MartinVerges/womolin-waterlevel/housing/Bodenplatte.stl

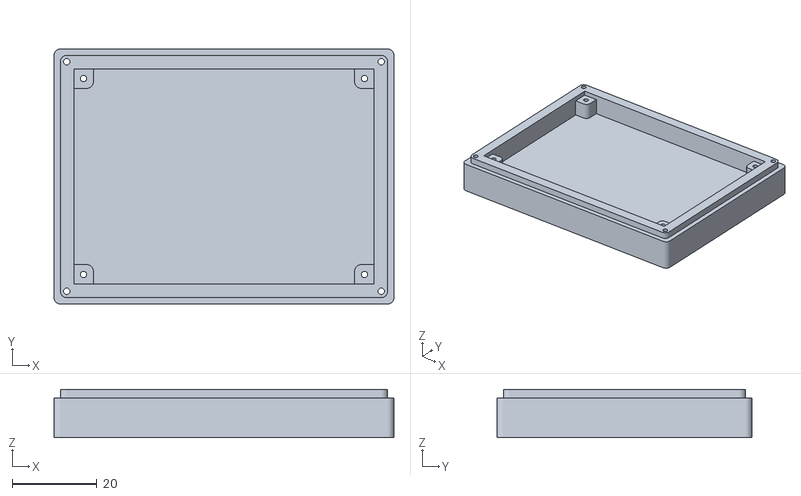
[picture p11: CAD file, 2021-12-18]
housing/Bodenplatte.stl
80.0 x 60.0 x 11.4
