MartinVerges/womolin-waterlevel/housing/Deckel.stl

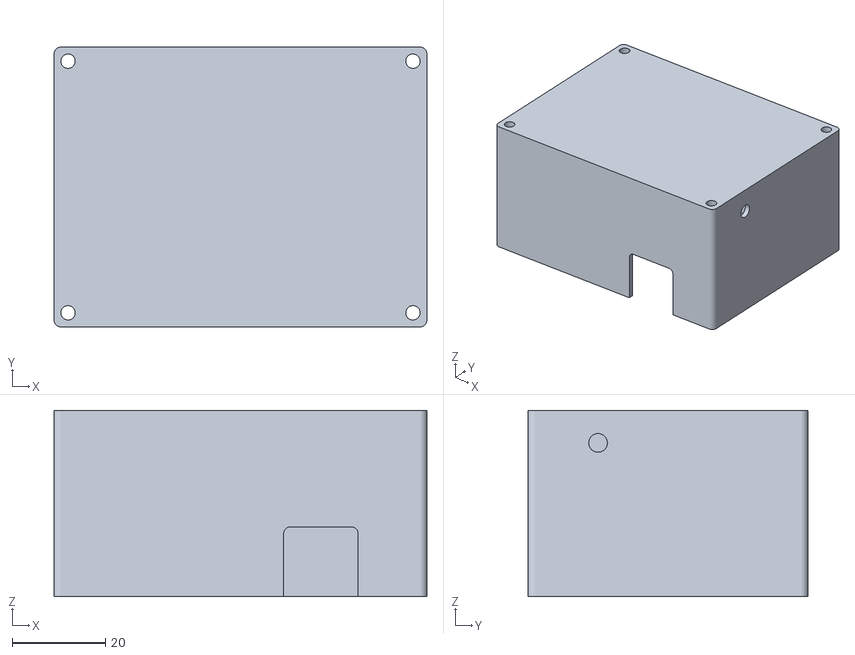
[picture p12: CAD file, 2021-12-18]
housing/Deckel.stl
80.0 x 60.0 x 40.0
