MartinVerges/womolin-waterlevel/(threads)

Thread 1 (2021-12-12):

Saving the settings in the EEPROM does not work yet

MartinVerges, 2021-12-12:
Currently, the configuration of the tank is not stored correctly in the EEPROM. Therefore, the tank must be relearned after each power loss.

MartinVerges, 2021-12-14:
fixed

Closed 2021-12-14.

Thread 2 (2021-12-29):

Thank you for this great simple sensor setup.

red-gee, 2021-12-29:
I like your setup much.
could you also implement Mqtt ?

MartinVerges, 2021-12-29:
Yes, i currently learn BLE and write a android app for it. Mqtt will be next, and easy to implement.

MartinVerges, 2022-01-17:
Sorry the BLE stuff took me way longer than expected. I reworked the UI a bit and can now add MQTT. Do you have any special requirements or needs? Otherwise I would just send the current level to a MQTT broker.

MartinVerges, 2022-01-18:
I just pushed an update including support for mqtt. It's not yet finished and mostly untested, but should already work. Please let me know if you encounter problems with it.

MartinVerges, 2022-01-19:
I pushed another update to it. Now more settings like user/pass are available and it's now working with my test mqtt broker. I would therefore close it as it's fully operational in my believe. Any objections?

Closed 2022-01-29.

Thread 3 (2022-03-06):

Höhenausgleich

Maik2016, 2022-03-06:
Hallo,

ich habe den Sensor ausprobiert, dabei ist mir aufgefallen, das beim Höhenwechsel die Werte sich Ändern, d.h. es würde den Richtigen Füllstand nur Anzeigen auf der Höhe bzw. Luftdruck wo Kalibriert wurde.  Ich konnte es jetzt nur auf geringen Höhenunterschied Beobachten.
Kann das jemand Bestätigen ?  GGF. könnte man mit einem BMP280 das ganze Kompensieren indem man den Vorherrschenden Luftdruck bei der Kalibrierung mit aufnimmt und immer dagegen Abgleicht.

MartinVerges, 2022-03-06:
Hallo,

da es sich um einen Differenzdruck Sensor handelt, sollte dies nicht auftreten, da die Höhe auf beiden Seiten den gleichen Druckunterschied verursacht.

Ich hatte in einem früheren Prototypen einen BMP Sensor und einen Drucksensor im Einsatz, jedoch hat dies zu erheblichen Abweichungen geführt.

Kannst du den Test den du gemacht hast genauer beschreiben?

Ich bin die letzten 4 Tage unterwegs gewesen und habe dabei ca. 400-500 Höhenmeter gehabt. Eine solche Abweichung habe ich jedoch nicht wahrgenommen. Was jedoch in meinem relativ breiten Tank massive Auswirkungen hat, ist die Neigung des Fahrzeugs. Da diese den Druck durch die größer werdenden Wassersäule verändert.

Grüße
Martin

PS: wir können gerne mal einen Video call machen und sprechen.

Maik2016, 2022-03-08:
Hallo,
Ich hatte auch so ca. 200m Höhenunterschied, es könnte auch am Schräg stehen gelegen haben, das muss ich noch mal testen, daher die Idee einen 2 Sensor als Umgebungsdruck Sensor zu verwenden.

Werde dich mal über Telegramm kontaktieren.
Vg.
Maik

MartinVerges, 2022-06-17:
Ich habe aktuell das Modell mit eine kleinen 60 cent Pumpe am laufen. Das funktioniert bei jeder höhe und das Rohr lässt sich neu mit dem Umgebungsdruck befüllen. Soweit wäre das eine Funktionierende Lösung die zu immer gleichen soliden und genauen Messwerten führt. Ganz happy bin ich damit leider nicht, weil ich eigentlich auf den Komplexitätsgrad verzichten würde!

Closed 2022-12-22.

Thread 4 (2023-06-13):

Füllstand einer Zisterne messen

deHarro, 2023-06-13:
Hallo Martin,
tolles Projekt und eine gute Idee!
Dies ist eigentlich kein Issue, eher eine Diskussion... eine Discussions Ecke kannst du über Github einrichten :)

Mein Ansinnen ist, den Füllstand einer Zisterne mit 4 m³ zu erfassen.
Die Zisterne ist im Garten eingegraben, Abstand zum Haus ca. 4 m.

Die direkte Messung wie in deinem Video gezeigt, wird auf Dauer nicht funktionieren, denke ich, da es (mir) unmöglich scheint, das Ganze System so abzudichten, dass auch über lange Zeit (Jahre) keine Luft aus dem Messsystem entweicht (oder im Wasser gelöst wird oder sonstwie abhanden kommt).

Dein zweiter Ansatz, die Luft erst zum Zeitpunkt der Messung per Pumpe ins System zu bringen, erscheint mir für diesen Einsatzfall jedoch super geeignet.
Meine Physikkenntnisse sind schon etwas eingerostet, aber ich denke, die Idee ist, dass der von der Pumpe erzeugte Druck im Schlauch dem außen (außerhalb des Sondenrohres ) anstehenden Wasserdruck entspricht, sobald die eingepumpte Luft unten aus dem Messrohr heraus blubbert und sich der Druck im Schlauch nicht mehr weiter erhöht.
Bin ich da auf dem Holzweg, oder stimmt meine Annahme?
Danke!

Harald

MartinVerges, 2023-06-13:
Hallo,

Ja, durch die kleine Luftpumpe wird das Problem mit etwaigen Undichtigkeiten behoben. Man bläst ein wenig Luft in das Messrohr bis es heraus blubbert. Sobald die Pumpe abgestellt wird, drückt das Wasser über die Luft im Rohr auf den Sensor der damit eine korrekte Messung durchführen kann.

Mit dem Repo und den Beispielaufbau kannst Du direkt Deine Zisterne messen. Das muss fehlerfrei klappen.

Grüße
Martin

deHarro, 2023-06-13:
Hi Martin,

für den gedachten Einsatzfall (und vor allem für die bei mir in der Schublade liegenden Teile aus einem anderen Projekt) ist dein Repo eher ungeeignet.

"..wenig Luft in das Messrohr..." ... Gilt das auch für eine ca. 3 m tiefe (bzw. den Wasserstand in dieser Höhe in der) Zisterne?
Da muss ich doch ggf. ziemlich Druck aufbauen, nach Adam Riese eben 3 bar. Und den Schlauch füllen...

Aber die Bestätigung meiner Annahme reicht mir schon erst mal, vielen Dank!
Dass die Bauelemente dann zum Einsatzfall passen, muss ich selbst sicher stellen.

Gruß, Harald

MartinVerges, 2023-06-13:
Es müssten 0,3 bar sein, oder nicht?

deHarro, 2023-06-14:
Natürlich 🥴. Ist mir heute Nacht auch noch durch die Birne geblitzt, da lag ich aber schon lange im Bett...

Dumm gelaufen, zumal ich eine halbe Stunde vorher Einheitenumrechnung geübt habe, um abzuschätzen, ob mein vorhandener Sensor für den zu erwartenden Druckbereich geeignet ist. Da musste ich kPa in mm Wassersäule für die Zisterne und in bar für den Kopf umrechnen.
Mein Sensor ist ein MPX5050G, der misst bis 50 kPa, also 5 m Wassersäule und natürlich 0,5 bar 😊, passt also wunderbar.
Die vorhandene Pumpe dürfte etwas zu grob sein, damit wollte ich die in meinem Autositz integrierten Luftpolster der Lordosestütze mit passendem Druck beaufschlagen. Das Projekt ist aber eingeschlafen, da ich zwischenzeitlich das Auto gewechselt habe 😃.
Ich kann dich gerne auf dem Laufenden halten, wenn es dich interessiert.
Oder du schaust [hier](http://harald-sattler.de/) nach, ob und wann es was geworden ist... Unter "Aktuell" erscheint dann irgendwann ein Link auf das Projekt.

Gruß, Harald

poweroxadmin, 2023-07-05:
Hallo Zusammen,

@Martin - erst einmal krass Respekt für das Projekt und Deine Vorarbeit, ich ziehe meinen Hut!
bei mir soll das ganze auch in zwei Zisternen eingebaut werden, und dann eben den Wasserstand messen.
Ich sehe das mit der Dichtigkeit und der feuchten Umgebung bei mir eher unkritisch.
Mein Aufbau würde vorsehen dass das Case mit Pumpe/Sensor/ESP/... entweder in einer Verteilung oder einem wasserdichten Case in einer Schlauchbox sitzt. Der Schlauch selbst sollte dann nicht länger als 10m werden.
Wenn es gut läuft, baue ich das noch vor dem Urlaub nach - mal schauen wie ich es schaffe.

Die beiden Fragen die ich mir gestellt habe waren in dem Zusammenhang nur ...
A - die Zistenern sind beide "liegende Zylinder" - da müsste ich mir dann für die Integration in Home Assistant eine Formel ausdenken mit der ich das Näherungsweise in Volumen umrechnen kann für ein Dashboard ...
oder habt Ihr da schon eine Lösungs-Idee?
B - zum Eichen des Systems - mein Ansatz wäre es die Zisterne maximal zu füllen, und dann das PVC-Rohr mit dem fixierten Schlauch drin, langsam in die Zisterne einführen und am Dom der Zisterne fixieren.
Das müsste doch technisch analog dem Befüllen des Tanks näherungsweise folgen.

Danke für Euer Feedback.

Gruß - Ralf

deHarro, 2023-07-05:
Hallo Ralf,

die Geschichte mit dem Eichen ist m.E. bei einer Tankform wie bei uns (liegender bzw. bei mir stehender Zylinder) unnötig.
Mit ein bisschen Physik kannst du vom Druck im Tauchrohr mehr oder weniger direkt den Füllstand in m, cm oder mm ableiten und mit den Formeln zum Inhalt von Zylindern daraus direkt den Inhalt in Litern oder mir auch in m³ ableiten.

Ich bin, angefixt von Martins Idee, auch gerade dran, unsere Zisterne messtechnisch zu erfassen. Das Programm steht soweit, momentan konstruiere ich den Meßaufnehmer (einen dünnen Schlauch, der in einem vorhandenen Leerrohr in die Zisterne geschoben werden wird und einem dünnen Rohr, das dann senkrecht in der Zisterne irgednwo fest gemacht wird.

Einen Einziehdraht (aus Kunststoff) habe ich an den vorhandenen drei Leitungen für die elektronische Füllstandsüberwachung vorbei schon in das Leerrohr eingeschoben, jetzt hadere ich mit den Möglichkeiten, einen glitschigen Kunststoffdraht mit dem PTFE-Röhrchen so zu verbinden, dass ich das Röhrchen ohne Abriss in das Leerrohr gezogen bekomme.

Die Elektronik (ein Digistump) wird im Haus platziert (die Zisterne ist ca. 4-5 m von Haus entfernt eingegraben), ich erwarte also keine Probleme im Zusammenhang mit Feuchte oder Getier.

Gruß, Harald

poweroxadmin, 2023-07-05:
Hallo Harald,

das ging ja schnell mit der Rückmeldung ... danke.
ja - ich bin da auch eher optimistisch, und hoffe dass das auf anhieb funktioniert.

zu Deinen Herausforderungen beim Einziehen des Schlauchs ...
erst einmal habe ich die Erfahrung gemacht braucht es viel VIEL Rohrgleitmittel :-)
und dann würde ich in den Schlauch was härteres einführen, und dann mit einem Draht den weichen schlauch darauf fixieren - aber ich denke da führen viele Wege zum Ziel.

Viel Erfolg jedenfalls!!!

Gruß |> Ralf

MartinVerges, 2023-07-05:
Hallo,

In der Software gibt es die Möglichkeit das Volumen anzugeben und so die verbleibenden Liter zu erhalten.

Wenn ihr Änderungen habt, ich bin da offen und hoffe das mehr Leute das nachbauen und nutzen.

Grüße

poweroxadmin, 2023-07-05:
Hallo Martin,
danke für die Bereitschaft zum Austausch ...
da ich hier dann meinen ersten "Sensor" und auch meinen ersten ESP verbaue,
wäre ich Dir dankbar wenn Du mir noch ein wenig mehr Einblick mit ein paar Bildern geben könntest,
wie Du das auf den Platten angeordnet bzw. fixiert hast.
ich denke ich bekomme das sicher irgendwie hin, aber bevor ich irgendwas kaputt mache bzw.
abbreche bin ich natürlich für alle Hinweise dankbar.
die Reihenfolge ist ja sicher erst einmal alles auf den Platten zusammenbauen, verdrahten & verlöten und dann die Software-Komponenten drauf bringen - oder?
Gruß |> Ralf

deHarro, 2023-07-05:
Hallo Martin, Ralf,

ich bin dabei, meine Umsetzung des Füllstandmessers auf meiner Homepage zu veröffentlichen.
Ist noch im Wachsen, aber ihr könnt gerne schon mal einen Blick auf die Seite werfen: [Füllstandmesser](http://harald-sattler.de/html/fullstandmesser.htm)
In den nächsten Tagen kommt noch die Verbindung zwischen Schlauch und Messrohr dazu und natürlich die Realisierung in der Zisterne.

Harald

@Ralf
Hast du eine Empfehlung für das Gleitmittel?
Ich habe in der Vergangenheit schon gelesen, dass Nivea für sowas verwendet wurde.
Die Einziehhilfe habe ich lieblos mit Maschinenfett eingesaut und nach gefühlt 2 Stunden effektiver Arbeit, mit Pausen, in denen ich mir die rote Hassmütze ganz tief ins Gesicht gezogen habe, weil das so überhaupt nicht funktionieren wollte, hat das Ende in der Zisterne gebaumelt.
Wenn ich beim Einziehen des Schlauchs auf halbem Weg die Verbindung abreiße, weiß ich nicht, ob ich einen zweiten Versuch unternehme...

deHarro, 2023-07-05:
Hallo Martin,

> Wenn ihr Änderungen habt, ich bin da offen und hoffe das mehr Leute das nachbauen und nutzen.

Wie oben schon geschrieben, ist mir deine umfängliche Lösung eine Nummer zu groß für meine Zisterne. Da ich keine kontinuierliche Erfassung benötige und keine Einbindung in eine Hausautomatisierung benötige, habe ich eigentlich keine Änderungswünsche für deine Implementierung. Der Einsatzfall Zisterne ist doch zu unterschiedlich zur Behälterüberwachung im WoMo.
Bei mir ist es eigentlich nur Neugier, die Nachspeisung mit Frischwasser erfolgt automatisch, wenn der Pegel zu weit absinkt.
Das Regenwasser wird bei uns übrigens für die Toilettenspülung verwendet, daher auch die Nachspeisung 😉.

Harald

poweroxadmin, 2023-07-06:
Mahlzeit ...
@Harald - nimm einfach das Gleitmittel aus dem Baumarkt dass benutzt wird um KG-Rohre miteinander zu verbinden.
Kleiner Tip bei Einziehhilfen - hier sind die am besten die "gedreht" sind - da verringert sich die Oberfläche und damit die Reibung - die sind um ein vielfaches besser, aber auch leider teurer. [Beispiel](https://www.amazon.de/Einziehband%EF%BC%8CEinziehdraht-4mm%EF%BC%8CEinziehhilfe%EF%BC%8CKabeleinziehhilfe%EF%BC%8CEinziehband-8m%EF%BC%8CEinziehspirale%EF%BC%8CWiro-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)
@MartinVerges
tut mir leid dass ich hier wahrscheinlich noch eine Lernkurve habe ... aber es ist leider mein erstes Projekt mit selbstgebautem Sensor.
in Deinem Schema sehe ich noch einen Transistor/Widerstand/Diode ... und den BMP180 - mal abgesehen dass es einen NodeMCU-32s zeigt, die Einkaufsliste referenziert den [ESP32-WROOM-32](https://womolin.de/produkt/wemos-d1-mini-esp32/). Hast Du das zwischenzeitlich im Projekt geändert, bzw. ist das Bild nicht ganz aktuell?

Vielen Dank für ein kurzes Feedback
Gruß - Ralf

deHarro, 2023-07-06:
Hi Ralf!
> Kleiner Tip bei Einziehhilfen - hier sind die am besten die "gedreht" sind - da verringert sich die Oberfläche und damit die Reibung - die sind um ein vielfaches besser, aber auch leider teurer. [Beispiel](https://www.amazon.de/Einziehband%EF%BC%8CEinziehdraht-4mm%EF%BC%8CEinziehhilfe%EF%BC%8CKabeleinziehhilfe%EF%BC%8CEinziehband-8m%EF%BC%8CEinziehspirale%EF%BC%8CWiro-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)

Hihi, gilt das auch für Plastikrohre mit 30 mm Innendurchmesser in dem schon drei ca. 7 mm dicke Gummikabel eingezogen sind?
Meine Kunststoff-Einziehhilfe hat 3 mm Durchmesser und ging gerade so durch.
Das von dir verlinkte Kabel hat eine 9 mm breite Öse angeschlagen. Weiß nicht, ob dafür überhaupt noch Platz in der Röhre ist.

Aber das Gleitzeugs habe ich mal bestellt... bin gespannt, Danke für die Tipps!

Harald

deHarro, 2023-07-15:
Update...

Der Tipp mit dem Gleitmittel war Gold wert, danke nochmal Ralf!!

Ich habe natürlich zuerst mal versucht, den Schlauch - mit etwas Gleitmittel - parallel zur Einziehhilfe und den drei Leitungen zusätzlich in das Rohr zu stopfen. Naja, hat dreimal nicht geklappt, dann hatte ich erst mal die Nase voll und habe mich schmollend anderen Dingen zugewandt.

Das Zusammenfuddeln des Schlauchs mit der Einziehhilfe zum Durchziehen hatte ich allerdings immer noch nicht gelöst, nicht mal ansatzweise.

Deshalb habe ich nach ein paar Tagen einen weiteren Versuch gewagt, wieder von innen im Keller und schiebend. Das hat den Charme, dass ich hier stehen kann und den Schlauch auf Augenhöhe bedienen kann, nicht wie an der Zisterne auf dem Bauch im Gras liegend.

Diesmal tat ich so richtig Gleitmittel auf den Schlauch und gleich von Anfang an, nicht erst nach dem ersten Meter und dann nur alle paar zehn Zentimeter. Und ich habe eine andere Stelle zwischen den drei Leitungen gewählt. Ach ja, und ich habe die kleine Schraube aus dem vorderen Ende entfernt, die ich dort reingedreht hatte, damit unterwegs kein Dreck in das Röhrchen kommt. Die Schraube stand nur ca. einen halben Millimeter über, aber immerhin.

Was genau jetzt der springende Punkt war, kann ich natürlich nicht sagen, aber auf jeden Fall hatte ich plötzlich ohne größere Probleme mit stecken bleiben oder abknicken nur noch ca. 3-4 m von dem Schlauch auf dem Boden liegen und dachte, jetzt schau ich mal draußen nach, ob der Schlauch schon rausschaut. Bingo! Dem war so 😊.

Bilder und so weiter stelle ich auf der HP zusammen ([Link](http://harald-sattler.de/html/fullstandmesser.htm)).

Harald

Thread 5 (2023-06-27):

Support for AJ-SR04M Sensor

s3m1s0n1c, 2023-06-27:
Hello,

Thanks for this awesome project.

Is there any way to support the AJ-SR04M Distance sensor instead ADC and MPX53DP?

Thanks
Sonic

MartinVerges, 2023-06-27:
Technically there is nothing that would prevent this. But I can't add it
without test equipment, so please feel free to add it to the code base and
I happily merge it.

However, please carefully check the manual. A quick search shows a range of
20cm – 450cm. For a tank level, this could be a show stopper.

Grüße

Sonic ***@***.***> schrieb am Di., 27. Juni 2023, 09:35:

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

s3m1s0n1c, 2023-06-27:
Well I would just need the gui changed so you can input the GPIO pins for Trigger and Echo..

What kind of sensors should I be using if this one is no good?

Thanks
Sonic

MartinVerges, 2023-07-05:
Why don't you try the one from my build?

Thread 7 (2023-08-25):

Air pressure measuring issues

OldPlanets, 2023-08-25:
Thanks for this great project. This was exactly what I was looking for, and it's great that someone else already did such a great job building and implementing it. 👍

Now about my issue: I'm not sure if it matters, as I'm not proficient enough in relevant physics, but I have chosen a different design for my measurement tube. Basically, I'm just using 4mm Quick Connectors with a check valve behind the pump, a Y-Connector to join the sensor and air pump tube, and then a bulkhead connector for the tank. So just one single, small tube is going into the tank. For me, this has the advantage of being easier to make; it looks cleaner, and I can leave the last part of the tube in the tank forever and just connect the tube from the device to the bulkhead connector.

I have tested it, and it is airtight and all, keeping the pressure over days. However, I have run into one issue: Using the pump produces a significantly higher pressure reading (about 10-15% in my local tests) inside the test tube than if I fill the empty jar (test tank) with water but don't use the pump. I'm sure there is an exact physical explanation for it, but I don't know it.

Does anyone know if that's because of my changed measurement tube, or does the suggested setup have similar issues? Does using a larger/wider tube mitigate it?

For now, I'm planning to just detect if the tank gets filled up (which only happens every few days anyway) and run the pump on those occasions, as well as running the pump between the setup steps when the water fills up, and reference values are taken.

On a side note: Right now, the build compensates changes in atmospheric pressure by running the pump. Wouldn't it theoretically be possible to compensate for the changes by calculation? So you could have builds without a pump, as long as your tank gets totally emptied every few days/weeks to make up for diffused air

MartinVerges, 2023-08-25:
Hello,

It already tries to compensate the ambient change a bit, but I'm not that
good in developing a solid math to do so reliable enough.

My first approach to solve the issue of going uphill and downhill was a
pump, but I couldn't find a air tight cheap small pump for this. Please
share the exact parts you are using, that's awesome.

Regarding the higher reading: Yes you have to wait a short time (2 sec or
so) until the pressure is on a correct level again. Besides that, nothing
that I noted so far using the pump.

Best regards
Martin Verges

OldPlanets ***@***.***> schrieb am Fr., 25. Aug. 2023, 06:45:

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

OldPlanets, 2023-08-25:
Parts for the tube I use? They are pretty standarized but I got mine here:
https://www.wassertechnik.pro/steckverbinder/metrisch/
On the attached picture you can see the three items I used (+ the tubes).

As for the pressure, no it's not just a few seconds, it stays constant for hours. And I'm sure it is actually higher pressure (so a physical thing) not a sensor issue. I'm just not sure what's causing it and if it's actually the proper measurement (and pouring water in without the air pump has some skew) or if something in my setup causes it. I suppose I should be able to calculate it, after all I know how much pressure a given water column should result in, but I haven't tried that yet.
But again, adjusting the code for it is not a problem, I'll probably go that way.

(I'm also doing some other changes because my build doesn't have a Wifi button, so I'll use power up to turn on Wifi for X minutes. And I'm also hoping to use the light sleep with BLE, whcih I read should be fine, but not there yet.)

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
