MartinVerges/womolin-waterlevel/PCB/Caravansensor.kicad_pcb

## KiCad design PCB/Caravansensor.kicad_pcb (2022-04-24)

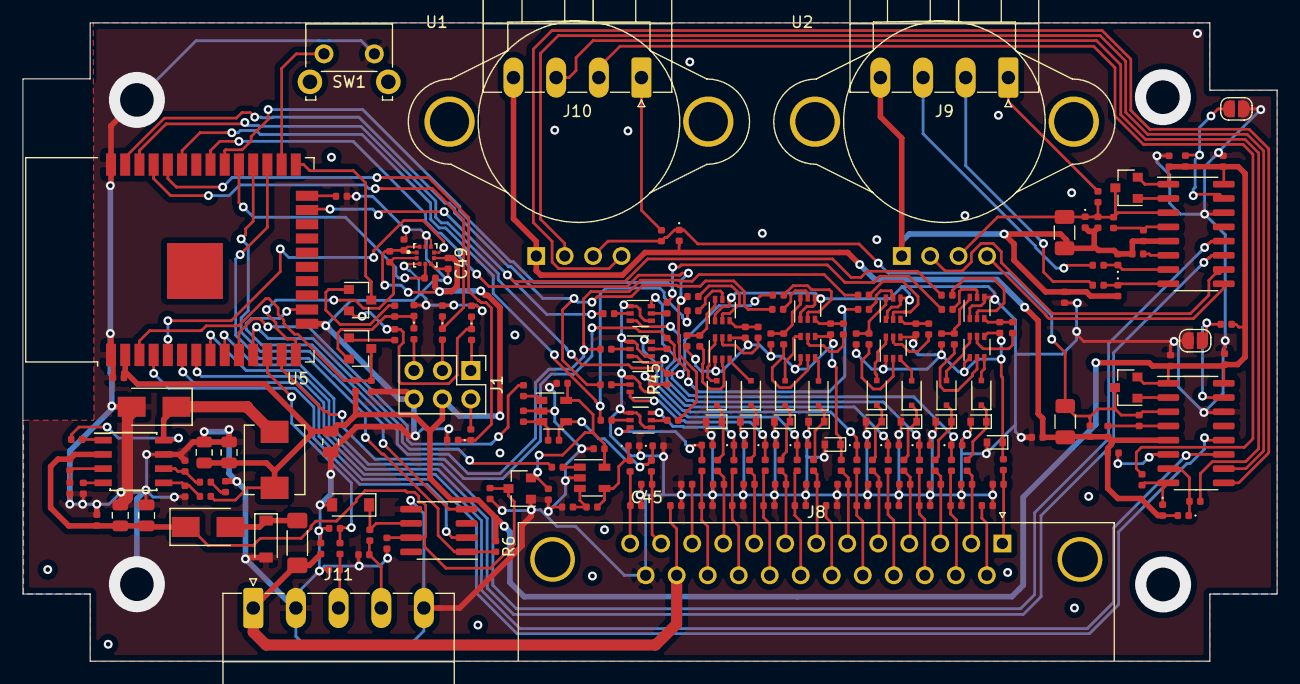
[picture p13: board Caravansensor.kicad_pcb from above]

Board: 2 copper layers, 112.0 x 57.0 mm, 226 parts (0 on the bottom side), 164 nets.

Parts:
C1, C2, C5, C6, C7, C8, C9, C10, C11, C12, C13, C14, C20, C21, C40, C41, C42, C43, C44, C47, C48, C49, C53: 100n; C_0402_1005Metric
C3, C4: 10u; C_1206_3216Metric
C15, C52: 100p; C_0402_1005Metric
C16, C17: 4u7; C_0805_2012Metric
C18, C51: 1n; C_0402_1005Metric
C19: 47p; C_0402_1005Metric
C22, C23, C50: 47u; C_0805_2012Metric
C24, C25, C26, C27, C28, C29, C30, C31, C32, C33, C34, C35, C36, C37, C38, C39, C45, C46: 10n; C_0402_1005Metric
D1, D3: SMF16A; D_SOD-123
D2, D4: B340A; D_SMA
D5, D6, D7, D8, D17, D18, D19, D20, D31, D32, D33, D34, D35, D36, D37, D38, D39, D40, D41, D42, D43: RCLAMP0521P-N; D_0402_1005Metric
D9, D10, D11, D12, D21, D22, D23, D24: 1N4148WS; D_SOD-323F
D13, D14, D15, D16, D25, D26, D27, D28, D29, D30: ESD5Z15V; D_SOD-523
F1: Polyfuse; Fuse_1806_4516Metric
J1: Conn_02x03_Odd_Even; PinHeader_2x03_P2.54mm_Vertical
J8: DB25_Female; DSUB-25_Female_Horizontal_P2.77x2.84mm_EdgePinOffset7.70mm_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
J9, J10: Conn_01x04; PhoenixContact_MC_1,5_4-G-3.81_1x04_P3.81mm_Horizontal
J11: Conn_01x05; PhoenixContact_MC_1,5_5-G-3.81_1x05_P3.81mm_Horizontal
JP2, JP3: Jumper_2_Open; SolderJumper-2_P1.3mm_Open_RoundedPad1.0x1.5mm
L1: SLO0630H6R8MTT; L_Neosid_SM-PIC0512H
L2, L3: L; L_0402_1005Metric
Q1, Q2: MMBTA92-Transistor_BJT; SOT-23
Q3, Q4: MMBT5401; SOT-23
Q5, Q6, Q7, Q8, Q11, Q12, Q13, Q14: LBSS260DW; SOT-363_SC-70-6
Q9, Q10, Q15, Q16: LBSS84DW; SOT-363_SC-70-6
R1, R3: 20k; R_0402_1005Metric
R2, R4: 8k2; R_0402_1005Metric
R5, R6, R8, R9, R19, R20, R21, R22, R23, R24, R25, R26, R27, R28, R29, R30, R31, R32, R33, R34, R43, R44, R45, R46, R47, R48, R49, R50, R51, R52, R53, R54, R55, R56, R57, R58, R90, R91: 10k; R_0402_1005Metric
R7, R13, R14, R15, R16, R71, R72, R77, R78, R79, R80, R81, R82, R83, R84, R85, R89: 100r; R_0402_1005Metric
R10: 332k; R_0402_1005Metric
R11: 68k1; R_0402_1005Metric
R12: 29k4; R_0402_1005Metric
R17: 10k2; R_0402_1005Metric
R18: 3k24; R_0402_1005Metric
R35, R36, R37, R38, R39, R40, R41, R42, R59, R60, R61, R62, R63, R64, R65, R66, R67, R69, R75, R76: 1k; R_0402_1005Metric
R68, R70: 200k; R_0402_1005Metric
R73, R74: 100k; R_0402_1005Metric
R86, R87: 4k7; R_0402_1005Metric
R88: 12k; R_0402_1005Metric
SW1: TS-1093A-A12B3-D2; SW_Tactile_SKHH_Angled
U1, U2: MPX53; 344C
U3, U4: HX711; SOIC-16_3.9x9.9mm_P1.27mm
U5: ESP32-WROOM-32D; ESP32-WROOM-32
U6: TJA1021T; SOIC-8_3.9x4.9mm_P1.27mm
U7: TPS54331D; SOIC-8_3.9x4.9mm_P1.27mm
U8, U9: LMV321; SOT-23-5
U10: BMP388; PQFN50P200X200X80-10N
U11: ME6209A50M3G; SOT-23

Connections:
1_Wire: D39.1, R89.2, U5.12
+3V3: C7.1, C8.1, C9.1, C10.1, C12.1, C22.1, C23.1, C49.1, C50.1, C53.1, J1.4, L1.2, Q1.2, Q2.2, R6.1, R17.1, R86.1, R87.1, R88.1, R90.2, R91.2, U3.1, U3.16, U4.1, U4.16, U5.2, U10.1, U10.6, U10.10
+5V: C40.2, C41.2, C48.1, U8.5, U9.5, U11.2
+BATT: C13.1, C14.1, C16.1, C17.1, C47.1, D2.1, R10.1, U6.7, U7.2, U11.3
BME_INT: U5.5, U10.7
FW_25: R22.2, R26.2, U5.30
FW_25_out_neg: C27.1, J8.15, R38.2
FW_25_out_pos: C31.1, J8.2, R42.2
FW_50: R21.2, R25.2, U5.23
FW_50_out_neg: C26.1, J8.16, R37.2
FW_50_out_pos: C30.1, J8.3, R41.2
FW_75: R20.2, R24.2, U5.13
FW_75_out_neg: C25.1, J8.17, R36.2
FW_75_out_pos: C29.1, J8.4, R40.2
FW_100: R19.2, R23.2, U5.16
FW_100_out_neg: C24.1, J8.18, R35.2
FW_100_out_pos: C28.1, J8.5, R39.2
FW_Analog_ESP: R67.2, U5.10
FW_Analog_out: C45.1, J8.12, R75.1
GND: C7.2, C8.2, C9.2, C10.2, C11.2, C12.2, C13.2, C14.2, C15.2, C16.2, C17.2, C19.2, C20.2, C22.2, C23.2, C24.2, C25.2, C26.2, C27.2, C28.2, C29.2, C30.2, C31.2, C32.2, C33.2, C34.2, C35.2, C36.2, C37.2, C38.2, C39.2, C40.1, C41.1, C42.2, C43.2, C44.2, C45.2, C46.2, C47.2, C48.2, C49.2, C50.2, C51.2, C52.2, C53.2, D1.2, D3.2, D4.2, D5.2, D6.2, D7.2, D8.2, D13.2, D14.2, D15.2, D16.2, D17.2, D18.2, D19.2, D20.2, D25.2, D26.2, D27.2, D28.2, D29.2, D30.2, D31.2, D32.2, D39.2, D40.2, D41.2, D42.2, D43.2, J1.6, J8.25, J11.2, J11.5, JP2.2, JP3.2, L2.2, L3.2, Q5.1, Q5.4, Q6.1, Q6.4, Q7.1, Q7.4, Q8.1, Q8.4, Q11.1, Q11.4, Q12.1, Q12.4, Q13.1, Q13.4, Q14.1, Q14.4, R5.2, R11.2, R12.2, R18.2, R68.2, R70.2, R77.2, R78.2, R79.2, SW1.2, U3.14, U4.14, U5.1, U5.15, U5.38, U6.5, U7.7, U8.2, U9.2, U10.3, U10.5, U10.8, U10.9, U11.1
GPIO_0: Q3.3, U5.25
INA_N_1: D38.1, R85.1, U4.7
INA_N_2: D37.1, R82.1, U3.7
INA_P_1: D36.1, R84.1, U4.8
INA_P_2: D35.1, R81.1, U3.8
LIN: C15.1, J11.4, R7.1
LIN_RX: R6.2, U5.27, U6.1
LIN_SLP: U5.4, U6.2
LIN_TX: U5.28, U6.4
unnamed: C1.1, C3.1, D33.1, Q1.3, R1.1, R80.1, U1.3, U3.3
unnamed: C1.2, C3.2, C5.2, D33.2, D35.2, D37.2, J10.4, L2.1, R2.2, U1.1, U3.5
unnamed: C2.1, C4.1, D34.1, Q2.3, R3.1, R83.1, U2.3, U4.3
unnamed: C2.2, C4.2, C6.2, D34.2, D36.2, D38.2, J9.4, L3.1, R4.2, U2.1, U4.5
unnamed: C5.1, U3.6
unnamed: C6.1, U4.6
unnamed: C18.1, C19.1, U7.6
unnamed: C18.2, R12.1
unnamed: C20.1, U7.4
unnamed: C21.1, U7.1
unnamed: C21.2, D4.1, L1.1, U7.8
unnamed: C42.1, J8.1, R71.2
unnamed: C43.1, J8.6, R72.2
unnamed: C52.1, J11.3, R89.1
unnamed: D1.1, D2.2, F1.1
unnamed: D3.1, R7.2, U6.6
unnamed: D5.1, Q7.6, R35.1
unnamed: D6.1, Q7.3, R36.1
unnamed: D7.1, Q8.6, R37.1
unnamed: D8.1, Q8.3, R38.1
unnamed: D9.2, Q9.6
unnamed: D10.1, D14.1, R40.1
unnamed: D10.2, Q9.3
unnamed: D11.1, D15.1, R41.1
unnamed: D11.2, Q10.6
unnamed: D12.1, D16.1, R42.1
unnamed: D12.2, Q10.3
unnamed: D9.1, D13.1, R39.1
unnamed: D17.1, Q11.6, R59.1
unnamed: D18.1, Q11.3, R60.1
unnamed: D19.1, Q12.6, R61.1
unnamed: D20.1, Q12.3, R62.1
unnamed: D21.1, D25.1, R63.1
unnamed: D21.2, Q15.6
unnamed: D22.1, D26.1, R64.1
unnamed: D22.2, Q15.3
unnamed: D23.1, D27.1, R65.1
unnamed: D23.2, Q16.6
unnamed: D24.1, D28.1, R66.1
unnamed: D24.2, Q16.3
unnamed: D31.1, R73.1, R75.2, U8.4
unnamed: D32.1, R74.1, R76.2, U9.4
unnamed: J1.1, R13.1
unnamed: J1.2, R16.2
unnamed: J1.3, R14.1
unnamed: J1.5, R15.1
unnamed: J8.11, R79.1
unnamed: J8.14, R77.1
unnamed: J8.19, R78.1
unnamed: J9.1, R83.2
unnamed: J9.2, R84.2
unnamed: J9.3, R85.2
unnamed: J10.1, R80.2
unnamed: J10.2, R81.2
unnamed: J10.3, R82.2
unnamed: JP2.1, R90.1, U3.15
unnamed: JP3.1, R91.1, U4.15
unnamed: Q1.1, U3.2
unnamed: Q2.1, U4.2
unnamed: Q3.1, R8.2
unnamed: Q4.1, R9.1
unnamed: Q5.2, R19.1
unnamed: Q5.3, R28.2, R32.2
unnamed: Q5.5, R20.1
unnamed: Q5.6, R27.2, R31.2
unnamed: Q6.2, R21.1
unnamed: Q6.3, R30.2, R34.2
unnamed: Q6.5, R22.1
unnamed: Q6.6, R29.2, R33.2
unnamed: Q7.2, R23.1
unnamed: Q7.5, R24.1
unnamed: Q8.2, R25.1
unnamed: Q8.5, R26.1
unnamed: Q9.2, R31.1
unnamed: Q9.5, R32.1
unnamed: Q10.2, R33.1
unnamed: Q10.5, R34.1
unnamed: Q11.2, R43.1
unnamed: Q11.5, R44.1
unnamed: Q12.2, R45.1
unnamed: Q12.5, R46.1
unnamed: Q13.2, R47.1
unnamed: Q13.3, R52.2, R56.2
unnamed: Q13.5, R48.1
unnamed: Q13.6, R51.2, R55.2
unnamed: Q14.2, R49.1
unnamed: Q14.3, R54.2, R58.2
unnamed: Q14.5, R50.1
unnamed: Q14.6, R53.2, R57.2
unnamed: Q15.2, R55.1
unnamed: Q15.5, R56.1
unnamed: Q16.2, R57.1
unnamed: Q16.5, R58.1
unnamed: R1.2, R2.1, U3.4
unnamed: R3.2, R4.1, U4.4
unnamed: R5.1, U5.24
unnamed: R10.2, R11.1, U7.3
unnamed: R17.2, R18.1, U7.5
unnamed: R67.1, U8.1
unnamed: R68.1, R73.2, U8.3
unnamed: R69.1, U9.1
unnamed: R70.1, R74.2, U9.3
unnamed: U1.2, U3.10
unnamed: U1.4, U3.9
unnamed: U2.2, U4.10
unnamed: U2.4, U4.9
unnamed: U3.11, U5.7
unnamed: U3.12, U5.6
unnamed: U4.11, U5.8
unnamed: U4.12, U5.9
PGM_CTS: D42.1, Q4.2, R8.1, R15.2
PGM_DTR: D40.1, Q3.2, R9.2, R13.2
PGM_RX: D43.1, R16.1, U5.34
PGM_TX: D41.1, R14.2, U5.35
Reset: C51.1, Q4.3, R88.2, U5.3
SCL: R86.2, U5.14, U10.2
SDA: R87.2, U5.29, U10.4
VBUS: C11.1, C44.1, F1.2, J8.24, J11.1
VCC: D29.1, Q9.1, Q9.4, Q10.1, Q10.4, R27.1, R28.1, R29.1, R30.1, R71.1
VCCQ: D30.1, Q15.1, Q15.4, Q16.1, Q16.4, R51.1, R52.1, R53.1, R54.1, R72.1
WLAN: SW1.1, U5.26
WW_25: R46.2, R50.2, U5.37
WW_25_out_neg: C35.1, J8.20, R62.2
WW_25_out_pos: C39.1, J8.7, R66.2
WW_50: R45.2, R49.2, U5.36
WW_50_out_neg: C34.1, J8.21, R61.2
WW_50_out_pos: C38.1, J8.8, R65.2
WW_75: R44.2, R48.2, U5.33
WW_75_out_neg: C33.1, J8.22, R60.2
WW_75_out_pos: C37.1, J8.9, R64.2
WW_100: R43.2, R47.2, U5.31
WW_100_out_neg: C32.1, J8.23, R59.2
WW_100_out_pos: C36.1, J8.10, R63.2
WW_Analog_ESP: R69.2, U5.11
WW_Analog_out: C46.1, J8.13, R76.1
