MartinVerges/womolin-waterlevel/src/main.cpp

/**
 * @file main.cpp
 * @author Martin Verges <martin@verges.cc>
 * @brief Tank level to MQTT with WiFi, BLE, and more
 * @version 0.1
 * @date 2022-07-09
 * 
 * @copyright Copyright (c) 2022 by the author alone
 *            https://gitlab.womolin.de/martin.verges/waterlevel
 * 
 * License: CC BY-NC-SA 4.0
 */

#if !(defined(AUTO_FW_VERSION))
  #define AUTO_FW_VERSION "v0.0.0-00000000"
#endif
#if !(defined(AUTO_FW_DATE))
  #define AUTO_FW_DATE "2023-01-01"
#endif
#if !(defined(ESP32))
  #error This code is intended to run on the ESP32 platform! Please check your Tools->Board setting.
#endif

#define uS_TO_S_FACTOR   1000000           // Conversion factor for micro seconds to seconds
#define TIME_TO_SLEEP    10                // WakeUp interval

// Fix an issue with the HX711 library on ESP32
#if !(defined(ARDUINO_ARCH_ESP32))
  #define ARDUINO_ARCH_ESP32 true
#endif
#undef USE_LittleFS
#define USE_LittleFS true

#include "log.h"

#include <Arduino.h>
#include <AsyncTCP.h>
#include <Preferences.h>
#include <ESPmDNS.h>
#include <WiFiUdp.h>

// Power Management
#include <driver/rtc_io.h>
#include <esp_sleep.h>
#include <soc/rtc.h>
#include <esp32/clk.h>

#include "global.h"
#include "api-routes.h"
#include "ble.h"
#include "dac.h"

#include <Adafruit_Sensor.h>
#include <Adafruit_BMP085_U.h>
Adafruit_BMP085_Unified bmp180 = Adafruit_BMP085_Unified(10085);
bool bmp180_found = false;

WebSerialClass WebSerial;

void initWifiAndServices() {
  if (enableOtaWebUpdate) {
    otaWebUpdater.setFirmware(AUTO_FW_DATE, AUTO_FW_VERSION);
    otaWebUpdater.startBackgroundTask();
    otaWebUpdater.attachWebServer(&webServer);
  }

  // Load well known Wifi AP credentials from NVS
  WifiManager.startBackgroundTask();
  WifiManager.attachWebServer(&webServer);
  WifiManager.fallbackToSoftAp(preferences.getBool("enableSoftAp", true));

  WebSerial.begin(&webServer);

  APIRegisterRoutes();
  webServer.begin();
  LOG_INFO_LN(F("[WEB] HTTP server started"));

  if (enableWifi) {
    LOG_INFO_LN(F("[MDNS] Starting mDNS Service!"));
    MDNS.begin(hostname.c_str());
    MDNS.addService("http", "tcp", 80);
    MDNS.addService("ota", "udp", 3232);
    LOG_INFO_F("[MDNS] You should be able now to open http://%s.local/ in your browser.\n", hostname);
  }

  if (enableMqtt) {
    Mqtt.prepare(
      preferences.getString("mqttHost", "localhost"),
      preferences.getUInt("mqttPort", 1883),
      preferences.getString("mqttTopic", "verges/waterlevel"),
      preferences.getString("mqttUser", ""),
      preferences.getString("mqttPass", "")
    );
  }
  else LOG_INFO_LN(F("[MQTT] Publish to MQTT is disabled."));
}

void setup() {
  Serial.begin(115200);
  Serial.setDebugOutput(true);

  LOG_INFO_LN(F("\n\n==== starting ESP32 setup() ===="));
  LOG_INFO_F("Firmware build date: %s %s\n", __DATE__, __TIME__);
  LOG_INFO_F("Firmware Version: %s (%s)\n", AUTO_FW_VERSION, AUTO_FW_DATE);

  print_wakeup_reason();
  LOG_INFO_F("[SETUP] Configure ESP32 to sleep for every %d Seconds\n", TIME_TO_SLEEP);

  LOG_INFO_F("[GPIO] Configuration of GPIO %d as INPUT_PULLUP ... ", button1.PIN);
  pinMode(button1.PIN, INPUT_PULLUP);
  attachInterrupt(button1.PIN, ISR_button1, FALLING);
  LOG_INFO_LN(F("done"));
    
  if (!LittleFS.begin(true)) {
    LOG_INFO_LN(F("[FS] An Error has occurred while mounting LittleFS"));
    // Reduce power consumption while having issues with NVS
    // This won't fix the problem, a check of the sensor log is required
    deepsleepForSeconds(5);
  }
  if (!preferences.begin(NVS_NAMESPACE)) preferences.clear();
  LOG_INFO_LN(F("[LITTLEFS] initialized"));

  float currentPressure = 0.f;
  sensors_event_t event;
  bmp180_found = bmp180.begin(BMP085_MODE_ULTRAHIGHRES);
  if (!bmp180_found) LOG_INFO_LN(F("[BMP180] Chip not found, disabling temperature and pressure"));
  else {
    bmp180.getEvent(&event);
    if (event.pressure) currentPressure = event.pressure; // hPa
  }

  for (uint8_t i=0; i < LEVELMANAGERS; i++) {
    LevelManagers[i]->setAutomaticAirPump(preferences.getBool("autoAirPump", true));
    LevelManagers[i]->setAirPressureThreshold(preferences.getUInt("pressureThresh", 10));
    LevelManagers[i]->setAirPressure(currentPressure, false);
    if (preferences.getBool("airPumpOnBoot", true)) {
      LevelManagers[i]->activateAirPump();
    }
    LevelManagers[i]->begin((String(NVS_NAMESPACE) + String("s") + String(i)).c_str());
  }

  // Load Settings from NVS
  hostname = preferences.getString("hostname");
  if (hostname.isEmpty()) {
    hostname = "waterlevel";
    preferences.putString("hostname", hostname);
  }
  enableWifi = preferences.getBool("enableWifi", enableWifi);
  enableBle = preferences.getBool("enableBle", enableBle);
  enableDac = preferences.getBool("enableDac", enableDac);
  enableMqtt = preferences.getBool("enableMqtt", enableMqtt);
  enableOtaWebUpdate = preferences.getBool("otaWebEnabled", enableOtaWebUpdate);

  if (!preferences.getString("otaWebUrl").isEmpty()) {
    otaWebUpdater.setBaseUrl(preferences.getString("otaWebUrl"));
  }

  if (enableWifi) initWifiAndServices();
  else LOG_INFO_LN(F("[WIFI] Not starting WiFi!"));

  if (enableBle) createBleServer(hostname);
  else LOG_INFO_LN(F("[BLE] Bluetooth low energy is disabled."));

  String otaPassword = preferences.getString("otaPassword");
  if (otaPassword.isEmpty()) {
    otaPassword = String((uint32_t)ESP.getEfuseMac());
    preferences.putString("otaPassword", otaPassword);
  }
  otaWebUpdater.setOtaPassword(otaPassword);
  LOG_INFO_F("[OTA] Password set to '%s'\n", otaPassword);

  preferences.end();

  for (uint8_t i=0; i < LEVELMANAGERS; i++) {
    if (!LevelManagers[i]->isConfigured()) {
      // we need to bring up WiFi to provide a convenient setup routine
      enableWifi = true;
    }
  }
}

// Soft reset the ESP to start with setup() again, but without loosing RTC_DATA as it would be with ESP.reset()
void softReset() {
  if (enableWifi) {
    webServer.end();
    MDNS.end();
    Mqtt.disconnect();
    WifiManager.stopWifi();
  }
  esp_sleep_enable_timer_wakeup(1);
  esp_deep_sleep_start();
}

void loop() {
  if (button1.pressed) {
    LOG_INFO_LN(F("[EVENT] Button pressed!"));
    button1.pressed = false;
    if (enableWifi) {
      // bringt up a SoftAP instead of beeing a client
      WifiManager.runSoftAP();
    } else {
      initWifiAndServices();
    }
    // softReset();
  }

  // Do not continue regular operation as long as a OTA is running
  // Reason: Background workload can cause upgrade issues that we want to avoid!
  if (otaWebUpdater.otaIsRunning) return sleepOrDelay();

  if (runtime() - Timing.lastServiceCheck > Timing.serviceInterval) {
    Timing.lastServiceCheck = runtime();
    // Check if all the services work
    if (enableWifi && WiFi.status() == WL_CONNECTED && WiFi.getMode() & WIFI_MODE_STA) {
      if (enableMqtt && !Mqtt.isConnected()) Mqtt.connect();
    }
  }

  for (uint8_t i=0; i < LEVELMANAGERS; i++) LevelManagers[i]->loop();

  // run regular operation
  if (runtime() - Timing.lastStatusUpdate > Timing.statusUpdateInterval) {
    Timing.lastStatusUpdate = runtime();

    String jsonOutput;
    StaticJsonDocument<1024> jsonDoc;

    sensors_event_t event;
    float temperature = 0.f;
    if (bmp180_found) {
      bmp180.getEvent(&event);
      bmp180.getTemperature(&temperature);
    } else {
      event.pressure = 0;
    }
    for (uint8_t i=0; i < LEVELMANAGERS; i++) {
      // Update air pressure value on all levelmanagers
      // 101.325 Pa = 101,325 kPa = 1013,25 hPa ≈ 1 bar.
      LevelManagers[i]->setAirPressure(event.pressure);

      if (LevelManagers[i]->isConfigured()) {
        String ident = String("level") + String(i);
        if (enableDac) dacValue(i+1, LevelManagers[i]->getLevel());
        if (enableBle) updateBleCharacteristic(i+1, LevelManagers[i]->getLevel());
        if (enableMqtt && Mqtt.isReady()) {
          Mqtt.client.publish((Mqtt.mqttTopic + "/tanklevel" + String(i+1)).c_str(), String(LevelManagers[i]->getLevel()).c_str(), true);
          Mqtt.client.publish((Mqtt.mqttTopic + "/tankvolume" + String(i+1)).c_str(), String(LevelManagers[i]->getCurrentVolume()).c_str(), true);
          Mqtt.client.publish((Mqtt.mqttTopic + "/sensorPressure" + String(i+1)).c_str(), String(LevelManagers[i]->getLastMedian()).c_str(), true);
          Mqtt.client.publish((Mqtt.mqttTopic + "/airPressure" + String(i+1)).c_str(), String(event.pressure).c_str(), true);
          Mqtt.client.publish((Mqtt.mqttTopic + "/temperature" + String(i+1)).c_str(), String(temperature).c_str(), true);
        }

        jsonDoc[i]["id"] = i;
        jsonDoc[i]["level"] = LevelManagers[i]->getLevel();
        jsonDoc[i]["volume"] = LevelManagers[i]->getCurrentVolume();
        jsonDoc[i]["sensorPressure"] = LevelManagers[i]->getLastMedian();
        jsonDoc[i]["airPressure"] = event.pressure;
        jsonDoc[i]["temperature"] = temperature;

        LOG_INFO_F("[SENSOR] Current level of %d. sensor is %d%% (raw %d, calculated %d)\n",
          i+1, LevelManagers[i]->getLevel(), (int)LevelManagers[i]->lastRawReading, LevelManagers[i]->getLastMedian()
        );
      } else {
        if (enableDac) dacValue(i+1, 0);
        if (enableBle) updateBleCharacteristic(i+1, 0);
        int tmp = LevelManagers[i]->getCalulcatedMedianReading();

        jsonDoc[i]["id"] = i;
        jsonDoc[i]["sensorValue"] = tmp;
        jsonDoc[i]["airPressure"] = event.pressure;
        jsonDoc[i]["temperature"] = temperature;

        LOG_INFO_F("[SENSOR] Sensor %d not configured, please run the setup! (raw %d, calculated %d)\n",
          i+1, (int)LevelManagers[i]->lastRawReading, LevelManagers[i]->getLastMedian()
        );
      }
    }

    serializeJsonPretty(jsonDoc, jsonOutput);
    events.send(jsonOutput.c_str(), "status", millis());
    //LOG_INFO_LN(jsonOutput);
  }
  sleepOrDelay();
}
