MartinVerges/womolin-waterlevel/src/tanksensor.cpp

/**
 *
 * Tanklevel Pressure Sensor
 * https://github.com/MartinVerges/rv-smart-tanksensor
 *
 * (c) 2022 Martin Verges
 *
**/

#if !(defined(ESP32))
  #error This code is intended to run on the ESP32 platform! Please check your Tools->Board setting.
#endif

#define uS_TO_S_FACTOR   1000000           // Conversion factor for micro seconds to seconds
#define TIME_TO_SLEEP    10                // WakeUp interval

// Fix an issue with the HX711 library on ESP32
#if !(defined(ARDUINO_ARCH_ESP32))
  #define ARDUINO_ARCH_ESP32 true
#endif
#undef USE_LittleFS
#define USE_LittleFS true

#include <Arduino.h>
#include <AsyncElegantOTA.h>
#include <AsyncTCP.h>
#include <Preferences.h>
#include <ESPmDNS.h>

// Power Management
#include <driver/rtc_io.h>
#include <esp_sleep.h>
#include <soc/rtc.h>
extern "C" {
  #if ESP_ARDUINO_VERSION_MAJOR >= 2
    #include <esp32/clk.h>
  #else
    #include <esp_clk.h>
  #endif
}


#include "global.h"
#include "api-routes.h"
#include "ble.h"
#include "dac.h"

void IRAM_ATTR ISR_button1() {
  button1.pressed = true;
}

void deepsleepForSeconds(int seconds) {
    esp_sleep_enable_timer_wakeup(seconds * uS_TO_S_FACTOR);
    esp_deep_sleep_start();
}

// Check if a feature is enabled, that prevents the
// deep sleep mode of our ESP32 chip.
void sleepOrDelay() {
  for (uint8_t i=0; i < LEVELMANAGERS; i++) {
    if (LevelManagers[i]->isSetupRunning()) {
      yield();
      delay(50);
      return;
    }
  }
  if (enableWifi || enableBle || enableMqtt) {
    yield();
    delay(50);
  } else {
    // We can save a lot of power by going into deepsleep
    // Thid disables WIFI and everything.
    esp_sleep_enable_timer_wakeup(TIME_TO_SLEEP * uS_TO_S_FACTOR);
    sleepTime = rtc_time_slowclk_to_us(rtc_time_get(), esp_clk_slowclk_cal_get());
    rtc_gpio_pullup_en(button1.PIN);
    rtc_gpio_pulldown_dis(button1.PIN);
    esp_sleep_enable_ext0_wakeup(button1.PIN, 0);

    preferences.end();
    Serial.println(F("[POWER] Sleeping..."));
    esp_deep_sleep_start();
  }
}

void print_wakeup_reason() {
  esp_sleep_wakeup_cause_t wakeup_reason;
  wakeup_reason = esp_sleep_get_wakeup_cause();

  switch(wakeup_reason) {
    case ESP_SLEEP_WAKEUP_EXT0 : 
      Serial.println(F("[POWER] Wakeup caused by external signal using RTC_IO"));
      button1.pressed = true;
    break;
    case ESP_SLEEP_WAKEUP_EXT1 : Serial.println(F("[POWER] Wakeup caused by external signal using RTC_CNTL")); break;
    case ESP_SLEEP_WAKEUP_TIMER : 
      Serial.println(F("[POWER] Wakeup caused by timer"));
      uint64_t timeNow, timeDiff;
      timeNow = rtc_time_slowclk_to_us(rtc_time_get(), esp_clk_slowclk_cal_get());
      timeDiff = timeNow - sleepTime;
      printf("Now: %" PRIu64 "ms, Duration: %" PRIu64 "ms\n", timeNow / 1000, timeDiff / 1000);
      delay(2000);
    break;
    case ESP_SLEEP_WAKEUP_TOUCHPAD : Serial.println(F("[POWER] Wakeup caused by touchpad")); break;
    case ESP_SLEEP_WAKEUP_ULP : Serial.println(F("[POWER] Wakeup caused by ULP program")); break;
    default : Serial.printf("[POWER] Wakeup was not caused by deep sleep: %d\n",wakeup_reason); break;
  }
}

void MDNSBegin(String hostname) {
  if (!enableWifi) return;
  Serial.println("[MDNS] Starting mDNS Service!");
  MDNS.begin(hostname.c_str());
  MDNS.addService("http", "tcp", 80);
}

void initWifiAndServices() {
  Serial.println(F("[DEBUG] calling initWifiAndServices()"));

  // Load well known Wifi AP credentials from NVS
  WifiManager.startBackgroundTask();
  WifiManager.attachWebServer(&webServer);
  WifiManager.fallbackToSoftAp(preferences.getBool("enableSoftAp", true));

  APIRegisterRoutes();
  AsyncElegantOTA.begin(&webServer);
  webServer.begin();
  Serial.println(F("[WEB] HTTP server started"));

  MDNSBegin(hostName);

  if (enableMqtt) {
    if (preferences.begin(NVS_NAMESPACE)) {
      Mqtt.prepare(
        preferences.getString("mqttHost", "localhost"),
        preferences.getUInt("mqttPort", 1883),
        preferences.getString("mqttTopic", "verges/tanklevel"),
        preferences.getString("mqttUser", ""),
        preferences.getString("mqttPass", "")
      );
      preferences.end();
    } else {
      Serial.println(F("[NVS] Unable to open NVS Namespace for MQTT"));
    }
  }
  else Serial.println(F("[MQTT] Publish to MQTT is disabled."));
}

void setup() {
  pinMode(airPump.PIN, OUTPUT);

  Serial.begin(115200);
  Serial.setDebugOutput(true);
  Serial.println(F("\n\n==== starting ESP32 setup() ===="));

  print_wakeup_reason();
  Serial.printf("[SETUP] Configure ESP32 to sleep for every %d Seconds\n", TIME_TO_SLEEP);

  Serial.printf("[GPIO] Configuration of GPIO %d as INPUT_PULLUP ... ", button1.PIN);
  pinMode(button1.PIN, INPUT_PULLUP);
  attachInterrupt(button1.PIN, ISR_button1, FALLING);
  Serial.println(F("done"));
  
  if (!LittleFS.begin(true)) {
    Serial.println(F("[FS] An Error has occurred while mounting LittleFS"));
    // Reduce power consumption while having issues with NVS
    // This won't fix the problem, a check of the sensor log is required
    deepsleepForSeconds(5);
  }
  if (!preferences.begin(NVS_NAMESPACE)) preferences.clear();

  Wire.begin(GPIO_NUM_5, GPIO_NUM_18);
  myBMP.begin(BMP085_ULTRAHIGHRES, &Wire);

  // Load Settings from NVS
  hostName = preferences.getString("hostName");
  if (hostName.isEmpty()) {
    hostName = "tanksensor";
    preferences.putString("hostName", hostName);
  }
  enableWifi = preferences.getBool("enableWifi", true);
  enableBle = preferences.getBool("enableBle", true);
  enableDac = preferences.getBool("enableDac", true);
  enableMqtt = preferences.getBool("enableMqtt", false);
  preferences.end();

  uint32_t currentPressure = myBMP.readPressure();
  for (uint8_t i=0; i < LEVELMANAGERS; i++) {
    LevelManagers[i]->setAirPressure(currentPressure);
    LevelManagers[i]->begin((String(NVS_NAMESPACE) + String("s") + String(i)).c_str());
  }
  
  for (uint8_t i=0; i < LEVELMANAGERS; i++) {
    if (!LevelManagers[i]->isConfigured()) {
      // we need to bring up WiFi to provide a convenient setup routine
      enableWifi = true;
    }
  }
  
  if (enableWifi) initWifiAndServices();
  else Serial.println(F("[WIFI] Not starting WiFi!"));

  if (enableBle) createBleServer(hostName);
  else Serial.println(F("[BLE] Bluetooth low energy is disabled."));
}

// Soft reset the ESP to start with setup() again, but without loosing RTC_DATA as it would be with ESP.reset()
void softReset() {
  if (enableWifi) {
    webServer.end();
    MDNS.end();
    Mqtt.disconnect();
    WifiManager.stopWifi();
  }
  esp_sleep_enable_timer_wakeup(1);
  esp_deep_sleep_start();
}

void loop() {
  // if WiFi is down, try reconnecting
  if (button1.pressed) {
    Serial.println(F("[EVENT] Button pressed!"));
    button1.pressed = false;
    if (enableWifi) {
      // bringt up a SoftAP instead of beeing a client
      WifiManager.runSoftAP();
    } else {
      initWifiAndServices();
    }
  }

  // Stop repressurizing the tube after X seconds
  if (airPump.enabled && runtime() - airPump.duration > airPump.starttime) {
    Serial.println(F("[AIRPUMP] Shutting down"));
    airPump.enabled = false;
    digitalWrite(airPump.PIN, LOW);
  }

  if (runtime() - Timing.lastServiceCheck > Timing.serviceInterval) {
    Timing.lastServiceCheck = runtime();
    // Check if all the services work
    if (enableWifi && WiFi.status() == WL_CONNECTED && WiFi.getMode() & WIFI_MODE_STA) {
      if (enableMqtt && !Mqtt.isConnected()) Mqtt.connect();
    }
    // Update air pressure value on all levelmanagers
    uint32_t currentPressure = myBMP.readPressure();
    for (uint8_t i=0; i < LEVELMANAGERS; i++) {
      LevelManagers[i]->setAirPressure(currentPressure);
    }
  }
  
  bool setup = false;
  for (uint8_t i=0; i < LEVELMANAGERS; i++) {
    if (LevelManagers[i]->isSetupRunning()) {
      setup = true;
      // run the level setup
      if (runtime() - Timing.lastSetupRead >= Timing.setupInterval) {
        Timing.lastSetupRead = runtime();
        int val = LevelManagers[i]->runLevelSetup();
        if (val > 0) {
          events.send(String(val).c_str(), "reading", runtime()); 
        } else {
          events.send("Unable to read data from sensor!", "setuperror", runtime());
          Serial.println(F("[SENSOR] Unable to read data from sensor!"));
        }
      }
    }
  }

  // run regular operation
  if (!setup && runtime() - Timing.lastSensorRead > Timing.sensorInterval) {
    Timing.lastSensorRead = runtime();

    int level;
    for (uint8_t i=0; i < LEVELMANAGERS; i++) {
      level = -1;
      if (LevelManagers[i]->isConfigured()) {
        level = LevelManagers[i]->getCalculatedPercentage();
        String ident = String("level") + String(i);
        events.send(String(level).c_str(), ident.c_str(), runtime());
        if (enableDac) dacValue(i+1, level);
        if (enableBle) updateBleCharacteristic(level);  // FIXME: need to manage multiple levels
        if (enableMqtt && Mqtt.isReady()) {
          Mqtt.client.publish((Mqtt.mqttTopic + "/tanklevel" + String(i+1)).c_str(), 0, true, String(level).c_str());
          Mqtt.client.publish((Mqtt.mqttTopic + "/sensorPressure" + String(i+1)).c_str(), 0, true, String(LevelManagers[i]->getSensorRawMedianReading(true)).c_str());
          Mqtt.client.publish((Mqtt.mqttTopic + "/airPressure" + String(i+1)).c_str(), 0, true, String(myBMP.readPressure()).c_str());
/*
          float alt = myBMP.readAltitude();
          Mqtt.client.publish((Mqtt.mqttTopic + "/temperature" + String(i+1)).c_str(), 0, true, String(myBMP.readTemperature()).c_str());
          Mqtt.client.publish((Mqtt.mqttTopic + "/sealevelpressure" + String(i+1)).c_str(), 0, true, String(myBMP.readSealevelPressure(alt)).c_str());
          Mqtt.client.publish((Mqtt.mqttTopic + "/altitude" + String(i+1)).c_str(), 0, true, String(alt).c_str());
*/
        }
        Serial.printf("[SENSOR] Current level of %d. sensor is %d%% (raw %d, calculated %d)\n",
          i+1, level, (int)LevelManagers[i]->getSensorRawMedianReading(true), LevelManagers[i]->getCalulcatedMedianReading(true)
        );
      } else {
        if (enableDac) dacValue(i+1, 0);
        if (enableBle) updateBleCharacteristic(0);  // FIXME
        level = LevelManagers[i]->getCalulcatedMedianReading();
        Serial.printf("[SENSOR] Sensor %d not configured, please run the setup! (raw %d, calculated %d)\n",
          i+1, (int)LevelManagers[i]->getSensorRawMedianReading(true), LevelManagers[i]->getCalulcatedMedianReading(true)
        );
      }
    }
  }
  sleepOrDelay();
}
