MartinVerges/womolin-waterlevel/tanksensor.ino

// Fix an issue with the HX711 library on ESP32
#undef ARDUINO_ARCH_ESP32
#define ARDUINO_ARCH_ESP32 true

#include <EEPROM.h>
#include "EEPROMAnything.h"

#include "HX711.h"
HX711 hx711;

struct Button {
  const uint8_t PIN;
  bool pressed;
};

Button button1 = {21, false};              // Run the setup 
Button button2 = {22, false};              // unused

const int GPIO_HX711_DOUT = 26;            // GPIO pin to use for DT or DOUT
const int GPIO_HX711_SCK = 25;             // GPIO pin to use for SCK

const float LOWER_END = 0.010;             // value increase to start recording (tank is empty)
const float UPPER_END = 0.990;             // value limit to cutoff data (tank is full)

struct config_t {
  bool setupDone = false;                  // Configuration done or not yet initialized sensor
  float readings[100] = {0};               // pressure readings to map to percentage filling
} levelConfig;
int currentState = 0;                      // last reading in percent
unsigned long millisStarted = 0;           // timer to run parts only at given interval

const int MAX_DATA_POINTS = 255;           // how many level data points to store (increased accuracy)
struct state_t {
  int valueCount = 0;                      // current number of entries in readings[]
  float minValue = 0.00;                   // lowest value to start recording
  float lastread = 0.00;                   // last redading while in setup  
  float readings[MAX_DATA_POINTS] = {0};   // data readings from pressure sensor while running level setup
} setupConfig;

void printData(float* readings, size_t count) {
  for (uint8_t i = 0; i < count; i++) Serial.printf("%d = %f\n", i, readings[i]);
}

int getPercentage(float val) {
  for(int x=99; x>0; x--) {
    if (val > levelConfig.readings[x]) return x+1;
  }
  return 0;
}

// Search through the setupConfig sensor readings and find the upper limit cutoff index
int findEndCutoffIndex() {
  float endCutoff = (setupConfig.readings[MAX_DATA_POINTS-1] - setupConfig.readings[0]) * UPPER_END + setupConfig.readings[0];
  int endIndex = -1;
  for (uint8_t i = 0; i < MAX_DATA_POINTS; i++) {
    if (setupConfig.readings[i] > endCutoff) {
      endIndex = i;
      break;
    }
  }
  return endIndex;
}

// Search through the setupConfig sensor readings and find the lower limit cutoff index
int findStartCutoffIndex(int endIndex) {
  float startCutoff = (setupConfig.readings[endIndex] - setupConfig.readings[0]) * LOWER_END + setupConfig.readings[0];
  int startIndex = -1;
  for (uint8_t i = 0; i < MAX_DATA_POINTS; i++) {
    if (setupConfig.readings[i] < startCutoff) startIndex = i;
    else break;
  }
  return startIndex;
}

void levelSetup() {
  if (setupConfig.readings[0] <= 0) {  // Start the level setup
    setupConfig.valueCount = 0;
    setupConfig.readings[setupConfig.valueCount++] = hx711.get_max_value(10);
    Serial.printf("Begin level setup with minValue of %f\n", setupConfig.readings[0]);
    return;
  }
  if (setupConfig.valueCount >= MAX_DATA_POINTS) {
    Serial.println("Exiting setup");

    std::sort(std::begin(setupConfig.readings), std::end(setupConfig.readings));
    // printData(setupConfig.readings, MAX_DATA_POINTS);
    int endIndex = findEndCutoffIndex();
    int startIndex = findStartCutoffIndex(endIndex);
    // Serial.printf("Start Index = %d\n", startIndex);
    // Serial.printf("End Index = %d\n", endIndex);

    // calculate the percentages
    int readingCount = endIndex - startIndex + 1;  // number of readings to use
    int x = startIndex;                        // index of reading[]
    float y1 = 0.00;                           // lower percentage of reading[] index (e.g. entry x equals 55%)
    float y2 = 0.00;                           // upper percentage of reading[] index (e.g. entry x+1 equals 58%)
    int Y = 0;                                 // % value (1-100%) 
    if (Y==0) levelConfig.readings[Y++] = setupConfig.readings[x];
    while(Y <= 100) {
      while (Y > y2 && x <= endIndex) {
        // find the next dataset to calculate Z
        y1 = (float)(x-startIndex  ) / readingCount * 100;     // lower percentage of this sensor reading
        y2 = (float)(x-startIndex+1.0) / readingCount * 100;     // upper percentage of the next sensor reading
        x++;
      }
      float Z = setupConfig.readings[x-1] + ((Y - y1) / (y2 - y1) * (setupConfig.readings[x] - setupConfig.readings[x-1])); // save the value into the configuration
      levelConfig.readings[Y] = Z;
      // Serial.printf("\t\t\ty1=\t%f\t | y2=\t%f\n", y1, y2);
      // Serial.printf("Y=%d\t| Z = %d | z1=\t%f\t| z2=\t%f\n", Y, (int)Z, setupConfig.readings[x-1], setupConfig.readings[x]);
      Y++;
    }
    // printData(levelConfig.readings, 100);
    levelConfig.setupDone = true;
    EEPROM_writeAnything(0, levelConfig);

    setupConfig.readings[0] = 0;
    setupConfig.valueCount = 0;
    return;
  }
  setupConfig.lastread = hx711.get_median_value(10);
  Serial.printf("Recording new entry with a value of %f\n", setupConfig.lastread);
  setupConfig.readings[setupConfig.valueCount++] = setupConfig.lastread;
}

void IRAM_ATTR ISR_button1() {
  button1.pressed = true;
}
void IRAM_ATTR ISR_button2() {
  button2.pressed = true;
}

void setup() {
  Serial.begin(115200);
  hx711.begin(GPIO_HX711_DOUT, GPIO_HX711_SCK, 32);

  EEPROM_readAnything(0, levelConfig);
  if (levelConfig.setupDone) {
    Serial.println("LevelData restored from EEPROM...");
    printData(levelConfig.readings, 100);
  } else {
    Serial.println("no stored configuration found on EEPROM...");
  }

  pinMode(button1.PIN, INPUT_PULLUP);
  attachInterrupt(button1.PIN, ISR_button1, FALLING);
  pinMode(button2.PIN, INPUT_PULLUP);
  attachInterrupt(button2.PIN, ISR_button2, FALLING);
}

/*
UNITS = one reading: 4768.1  | average:  4768.9
VALUE = one reading:  477464.0  | average:  476669.0
RAW   = one reading:  4316381 | average:  4315608
 */
void readPressure() {
  if (hx711.wait_ready_retry(100)) {
    currentState = getPercentage(hx711.get_median_value(10));
    Serial.printf("Tank fill status = %d\n", currentState);
  } else {
    Serial.println("Unable to communicate with the HX711 modul.");
  }
}

void loop() {
  if (button1.pressed) {
    if (setupConfig.readings[0] > 0) {
      Serial.println("User requested end of setup...");
      while(setupConfig.valueCount < MAX_DATA_POINTS) {
        setupConfig.readings[setupConfig.valueCount++] = setupConfig.lastread;
      }
    }
    levelSetup();
    button1.pressed = false;
  }

  if (button2.pressed) {
    button2.pressed = false;
    printData(levelConfig.readings, 100);
  }
  
  if (setupConfig.readings[0] > 0) {
    // run the level setup
    if (millis() - millisStarted >= 100) {
      millisStarted = millis();
      levelSetup();
    }
  } else {
    // run regular operation
    if (millis() - millisStarted > 1000) {
      millisStarted = millis();
      if (levelConfig.readings[0] > 0) readPressure();
      else Serial.println("No leveldata found, please run the setup to use the device!");
    }
  }
  delay(25);
}
