MartinVerges/womolin-waterlevel/(commit log)

2021-12-12 working prototype
2021-12-12 different EEPROM approach, still not working ;/
    [tanksensor.ino]
2021-12-13 Settings now stored and reloaded Added webserver for future use
    [partitions.csv]
2021-12-14 fix dependencies, initial linter config
    [tanksensor.cpp]
2021-12-14 more small cleanup and fixes
    [tanksensor.cpp]
2021-12-14 sensor function seperated
2021-12-15 massive api upgrade
    add lot's of entpoints for plain and json
    add alternative setup for linear tanks
    fixed dozens of bugs (to many to count)
    improved UI overall
    Current state of work, it's usable!
    [sensor.cpp, sensor.h, tanksensor.cpp]
2021-12-16 Add schematic
2021-12-18 add housing pics to readme
2021-12-18 add 3D housing
    [Bodenplatte.stl, Deckel.stl]
2021-12-19 added analog output (0-3.3V) and lots of improvem.
2021-12-21 remove double reset detection
    [tanksensor.cpp]
2021-12-23 increase precision, split code, more api, bugfixes
    [api-routes.h, global.h, tanklevel.cpp, tanklevel.h, tanksensor.cpp]
2021-12-23 modal fix, push button enables wifi, then portal
    [api-routes.h, global.h, tanksensor.cpp]
2021-12-24 better documentation, DAC output, minor bugfixes
    [global.h, tanksensor.cpp]
2021-12-24 fix build dependency issue
    [global.h, tanksensor.cpp]
2021-12-25 change ADC range from 0.5V=0% up to 3.0V=100%
2021-12-30 Update README.md
    Add more power consumption details
2022-01-02 initial bluetooth support but now to large for OTA
    [partitions.csv]
2022-01-17 Add License, drop Bootstrap, add BLE
    Added a CC-NC-SA License to the project
    Dropped Bootstrap CSS and JS due to size
    Add working BLE stack to support the Android APP
    Migrated Configuration in a individual page
    Updated README and Screenshots
    [partitions.csv]
2022-01-19 New screenshots, new API endpoints, fixed API bugs
    - Screenshots of the new configuration options
    - Reworked some API endpoints, fixed bugs like /api/level output
    - Fixed small HTML bugs
    - Updated API Insomnia config file
    - and more
    [api-routes.h, tanklevel.cpp, tanklevel.h, tanksensor.cpp]
2022-03-31 rewrote MQTT connector
2022-04-09 First Schematic draft, include Interface for common caravan Panels (Arsilicii, CBE, Nordeletronica, Schaudt), LIN and onwire Interface for other controls.
    [Caravansensor.kicad_pcb, Caravansensor.sch, Panelinterface.sch, Sensor-Connection.sch]
2022-04-18 initial version to support multiple sensors on a single esp32
2022-04-24 Layout complete, LIN, Added, 1wire added, Power supply added
    [Caravansensor.kicad_pcb]
2022-04-28 fix nvs storage bug, add airPump to repressurize, updated wifimanger, more
    [api-routes.h, global.h, tanklevel.cpp, tanklevel.h, tanksensor.cpp]
2022-04-29 drop air pump because it's not tight
    [api-routes.h, global.h, tanksensor.cpp]
2022-05-05 add initial functions to compensate using bmp pressure sensuor
2022-05-08 Upg to IDF 4.2 based arduino espressif32 framework
2022-05-20 use latest esp32-wifi-manager
2022-05-23 Revert "drop air pump because it's not tight"
    This reverts commit 07c289f8a3a6892c7248a57934f4b1f7d9e76e7b.
    [api-routes.h, global.h, tanksensor.cpp]
2022-05-23 working pump+bmp prototype
2022-05-23 UI update, allow tube repressurise
2022-06-03 add repressurize to UI, fixed MQTT user/pass bug
    [tanksensor.cpp]
2022-06-13 build new gui into firmware
    [partitions.csv]
2022-07-15 update docs, pics, schematics. Drop insomnia spec
2022-07-17 correct schematic
2022-07-21 fix crash on missing bmp180, set ota mdns hostname
    [main.cpp]
2022-08-24 fix activity icon for multi pump sensors
2022-08-24 automatic repressurize on pressure change
2022-08-25 add api to allow partition switch
2022-08-25 fix airpump api function
    [api-routes.h, tanklevel.cpp]
2022-09-08 add BOM article links
2022-10-21 fix author email address
    [api-routes.h, ble.cpp, ble.h, dac.h, global.h, main.cpp, tanklevel.cpp, tanklevel.h]
2023-01-07 Versioning and Gitlab CI pipeline
    [partitions.csv]
2023-01-09 removed ArduinoOTA, added WebUpdate from S3,
    [partitions.csv]
2023-02-26 fix IP address output from MQTT
    [MQTTclient.cpp]
2023-03-19 update BOM
2023-05-04 fix #6: Add option to enable/disable air pump on boot
    [api-routes.h, main.cpp, tanklevel.cpp, tanklevel.h]
